JeffBVaughan/SilentDisco/hardware/previews/dial-base.png

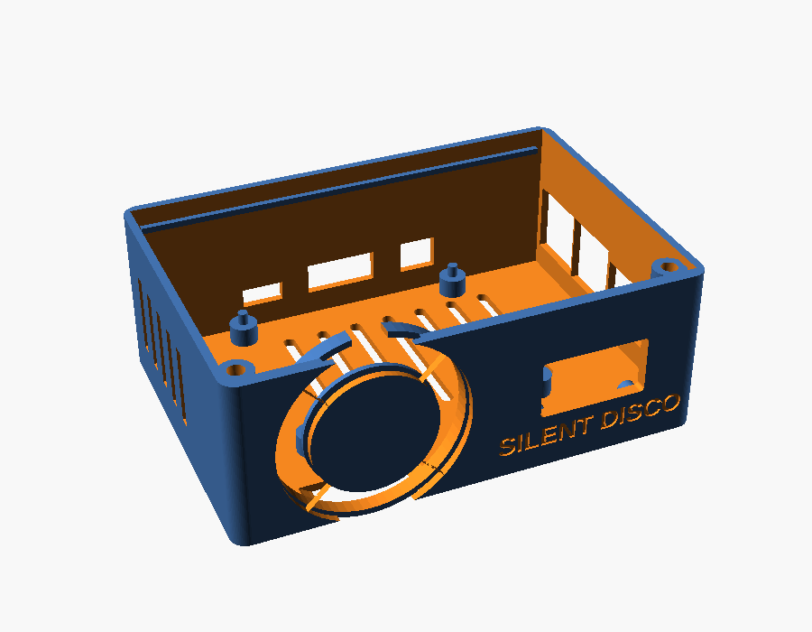
hardware/previews/dial-base.png
