JeffBVaughan/SilentDisco/hardware/previews/dial-lid.png

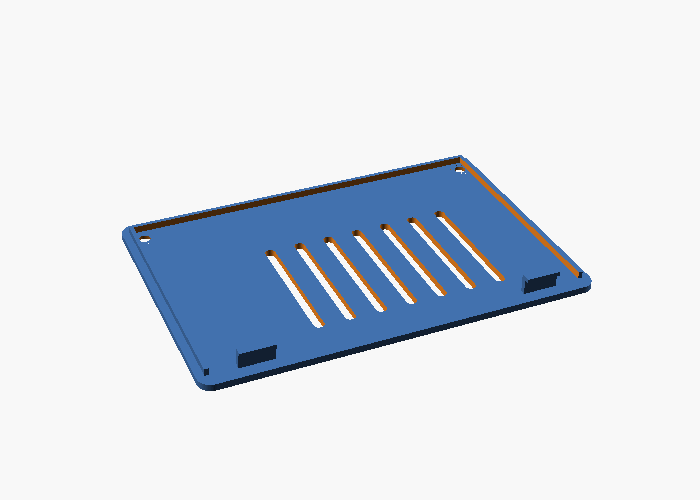
hardware/previews/dial-lid.png
