JeffBVaughan/SilentDisco/hardware/previews/halo-clip.png

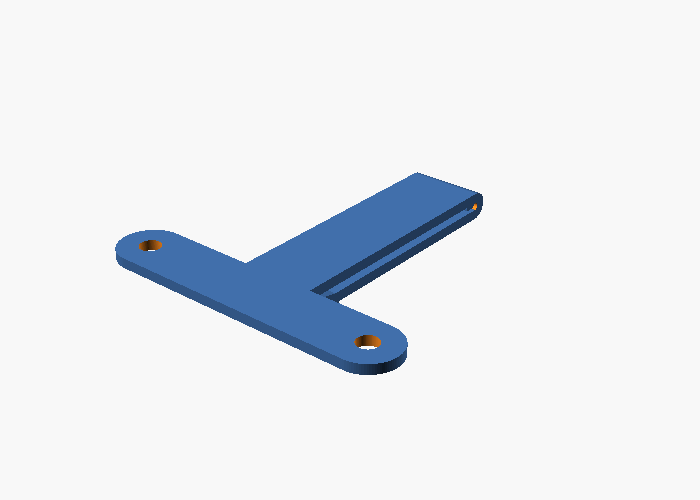
hardware/previews/halo-clip.png
