JeffBVaughan/SilentDisco/hardware/previews/halo-lid.png

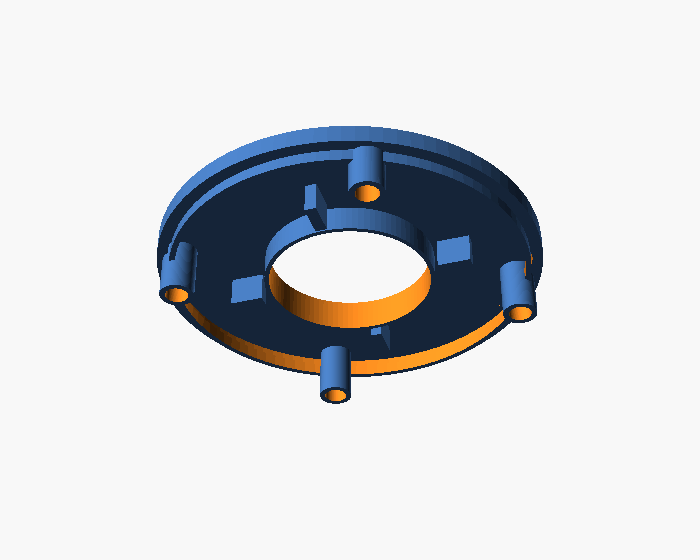
hardware/previews/halo-lid.png
