JeffBVaughan/SilentDisco/hardware/previews/halo-tray.png

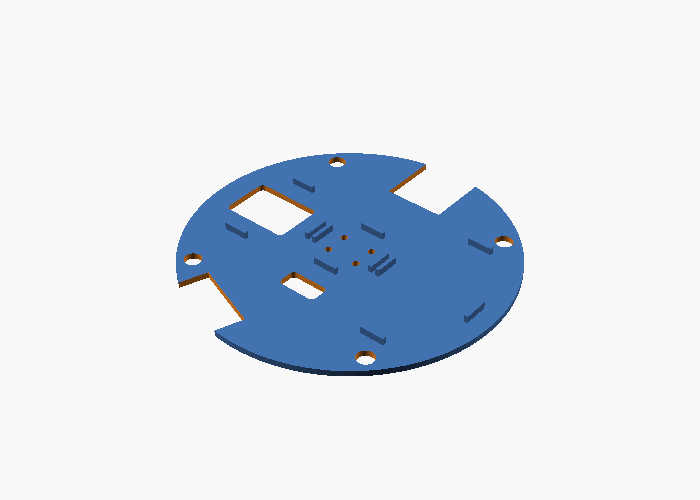
hardware/previews/halo-tray.png
