JeffBVaughan/SilentDisco/(commit log)

2026-10-31 Add Raspberry Pi Snapcast server setup with four colour channels
    Installer, snapserver config, per-channel ffmpeg looper service, QR join
    script and a README covering flashing, install, adding music, joining
    from phones, sync testing, and how the owner's parts inventory fits.
    Claude-Session: https://claude.ai/code/session_011QwK4fix7WnZaHcaYfiLaE
2026-10-31 Add puck parts list, wiring sketch and kit-level extras
    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
2026-10-31 Add interactive puck and server housing mockup page
    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
2026-10-31 Use M3 inserts and screws for the shells
    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
2026-10-31 Installer: detect the snapserver service user, looper owns the FIFOs
    Debian/Raspberry Pi OS package the service user as _snapserver, the
    upstream .deb as snapserver. Ask systemd for the unit's User and
    substitute it into the looper unit. The looper now creates each FIFO
    and snapserver opens it read-only, so it works under the hardened unit.
    Also adds the first OpenSCAD models for the Halo puck and Dial server box.
    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
    [dial.scad, halo.scad]
2026-10-31 Hardware README, previews, parts list updates for the Halo and Dial models
    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
    [dial.scad]
2026-10-31 Halo: fit the PJ30920-D pre-wired panel jack under the ring, move bosses off the battery corners
    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
    [halo.scad]
2026-10-31 Add the server box face: LED ring quadrants + OLED join QR, driven from the Pi
    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
2026-11-01 Join page: one socket per page, cached group id, newest tap wins
    Each tap used to open another WebSocket; fast switching stacked clients and
    hung. Connection is now a singleton, the group lookup is cached so a switch
    is a single RPC, and in-flight taps are superseded by newer ones.
    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
2026-11-01 Stream Opus: join page decodes it with WebCodecs, server config switches to opus
    A Pi 3B on Wi-Fi could not sustain PCM to two listeners. Opus is a tenth
    of the bandwidth; one packet per 20 ms chunk maps straight onto the
    browser's AudioDecoder. PCM path kept. Tested headless on both.
    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
2026-11-01 Join page: jitter-tolerant clock, soft drift correction, pinned sample rate
    Phones on Wi-Fi have lopsided round trips; the clock now trusts the
    shortest-RTT samples and slews instead of jumping. Drift is corrected by
    trimming or padding up to 1% of a chunk rather than re-anchoring, and the
    audio context runs at the stream rate so chunks are not resampled one by
    one. #debug shows the live numbers (snapserver 404s on query strings).
    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
2026-11-01 Join page: per-device sync slider, output latency in the debug readout
    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
2026-11-01 Join page: opening burst of time samples, clock locks once audio flows
    Startup was choppy while the clock estimate settled faster than the
    scheduler's soft correction could follow. Twelve samples are taken before
    playback starts; after the first anchor the offset slews at 10 ms/s, within
    what trim/pad correction absorbs.
    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
